cnahikian/Electrical-Engineering-Design-1-Final-Project/README.md

# Electrical-Engineering-Design-1-Final-Project
All files related to my final project for my Electrical Engineering Design 1 Class (EEL3924C)
