cnahikian/Electrical-Engineering-Design-1-Final-Project/Final Project Block Diagram.pptx

LCD

7 Buttons
(with LEDs)

PIC18
Microcontroller

Speaker

2 Buttons
(Mode and Start)

7 LEDs
(on buttons)

Potentiometer

## Slide 2

Start

Declare
Variables

Turn on and off LEDs and loop through delays

Check LEDs, check buttons

Increase score and continue to loop through game

Reach end conditions;
Start audio, write to LCD

Return to idle position if new game is not started

Initialize Ports,
SPI, ADC, LCD, Timer, etc.

Initialize values

Take in “game mode” value and select

Start audio, write to LCD

Start Timer

Stop
