cnahikian/Electrical-Engineering-Design-1-Final-Project/panel_design.pdf

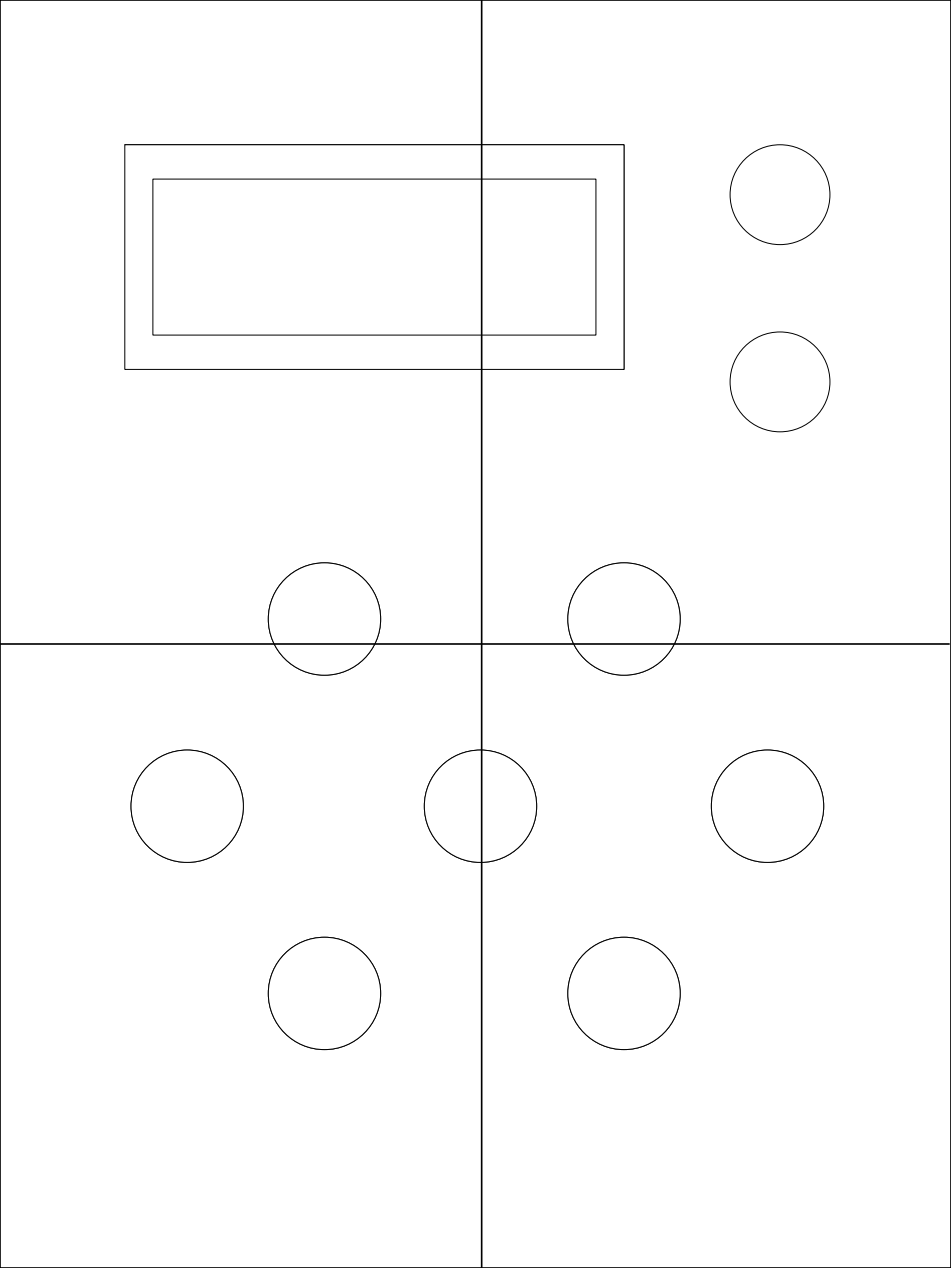
[picture p9: page 1]
