cnahikian/Electrical-Engineering-Design-1-Final-Project/(list of files, drawings)

Other design files:
final.SchDoc
PCB1.PcbDoc
